NMieville/PA/hardware/dipole/C10/README.md

# KiCad JDC project template

Pour rendre ce template disponible dans KiCad, il faut copier ce repo dans `.../KiCad/[version]/template/`.

Il est ensuite disponible lorsqu'on sélection **New Project from Template...** puis **User Templates** dans KiCad.
