NMieville/PA/rapport/annexe.tex

\appendix

\section{Mesures capacitives RC}
\label{mesrc}
\begin{figure}[!ht]
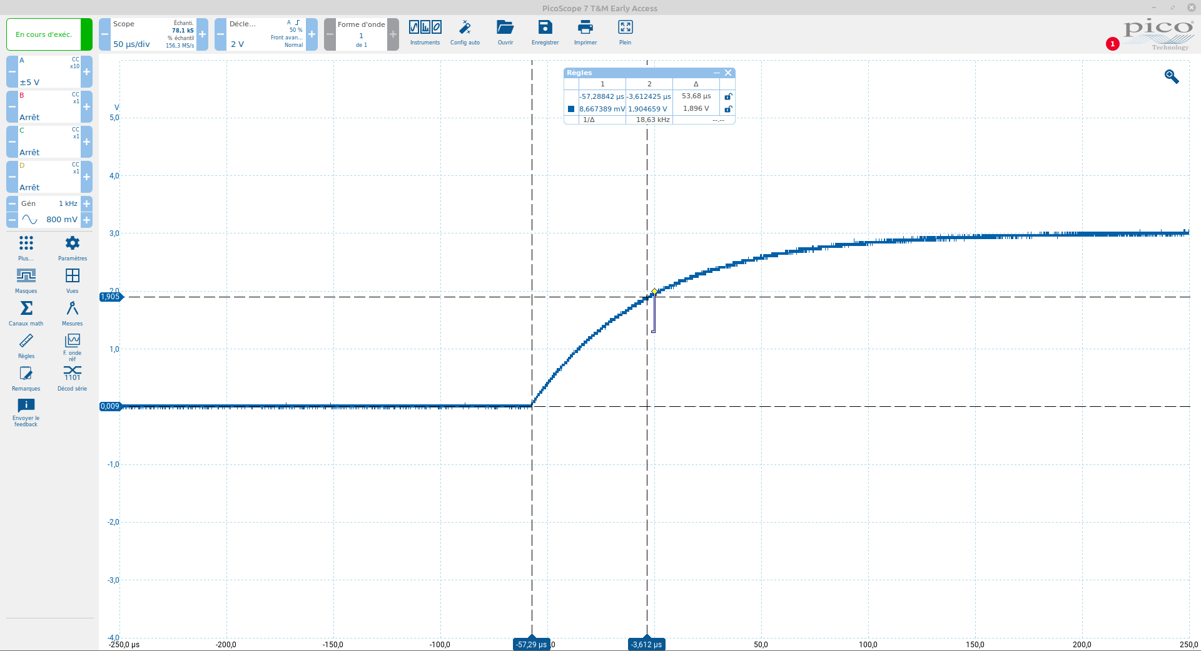
[picture p1: rapport/figuresMeasure/a.png]
  
  \caption{Oscillogramme de mesure RC du PCB A}
\end{figure}

\begin{figure}[!ht]
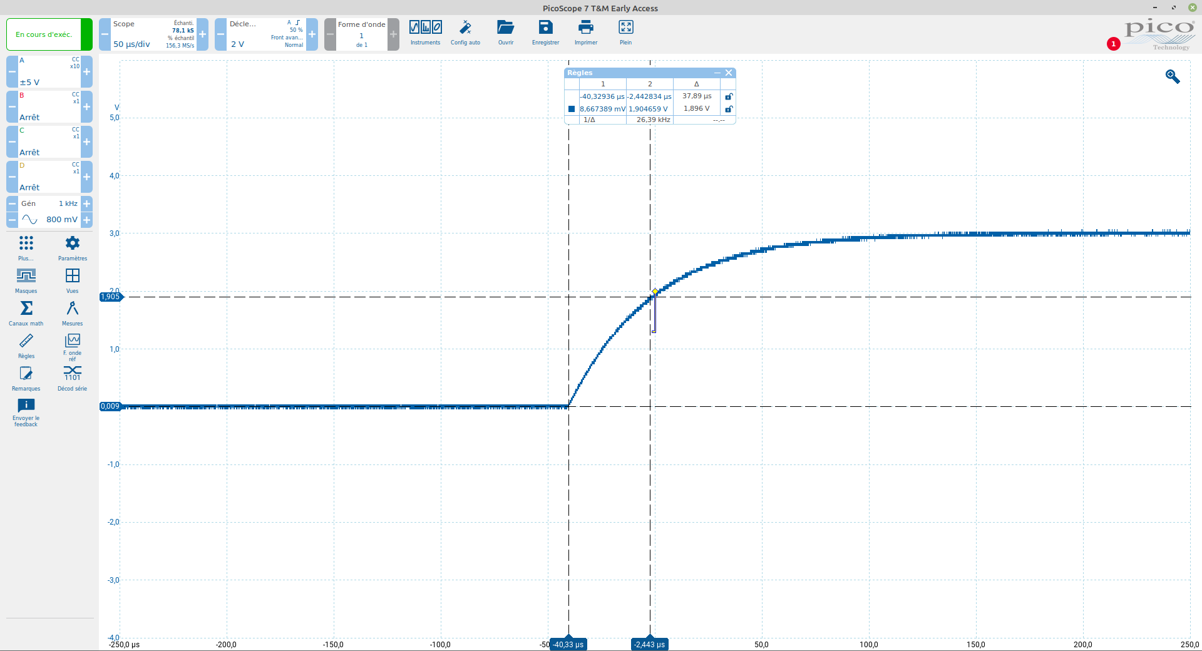
[picture p2: rapport/figuresMeasure/b.png]
  
  \caption{Oscillogramme de mesure RC du PCB B}
\end{figure}

\newpage

\begin{figure}[!ht]
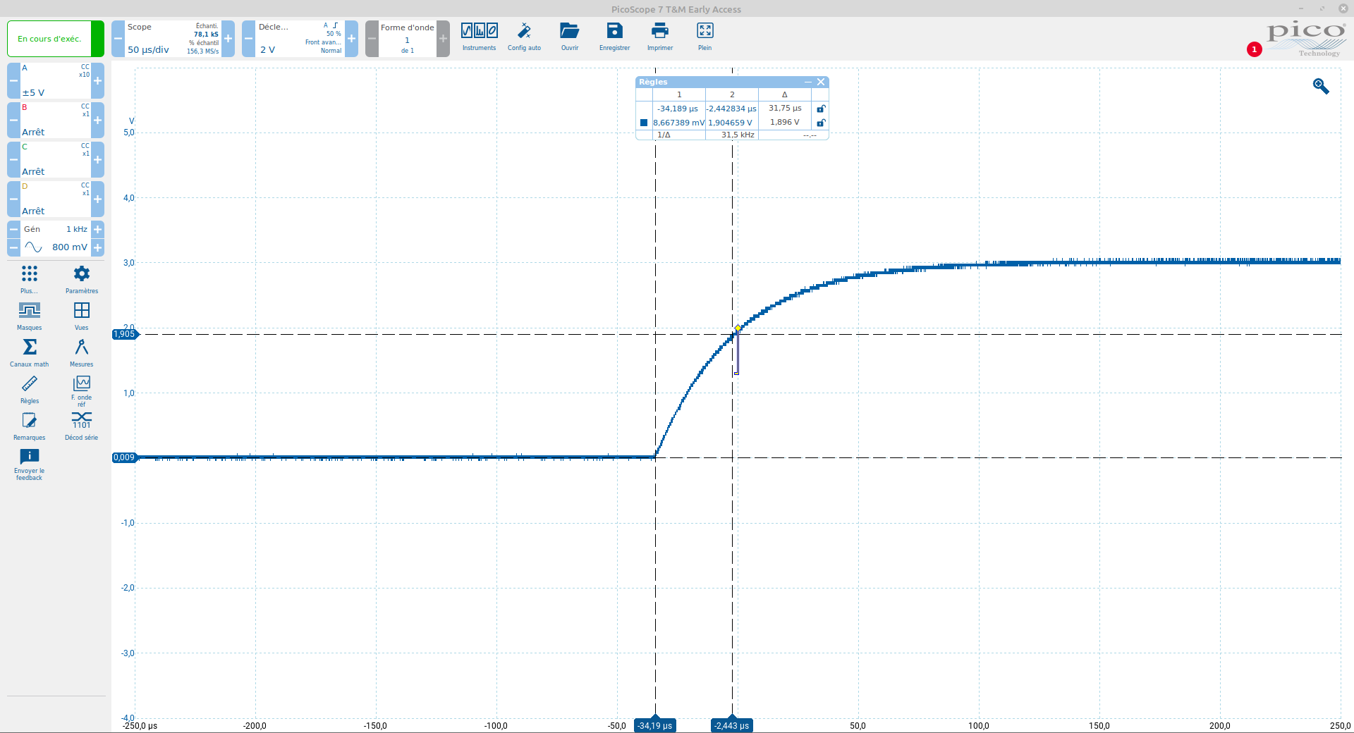
[picture p3: rapport/figuresMeasure/c.png]
  
  \caption{Oscillogramme de mesure RC du PCB C}
\end{figure}

\begin{figure}[!ht]
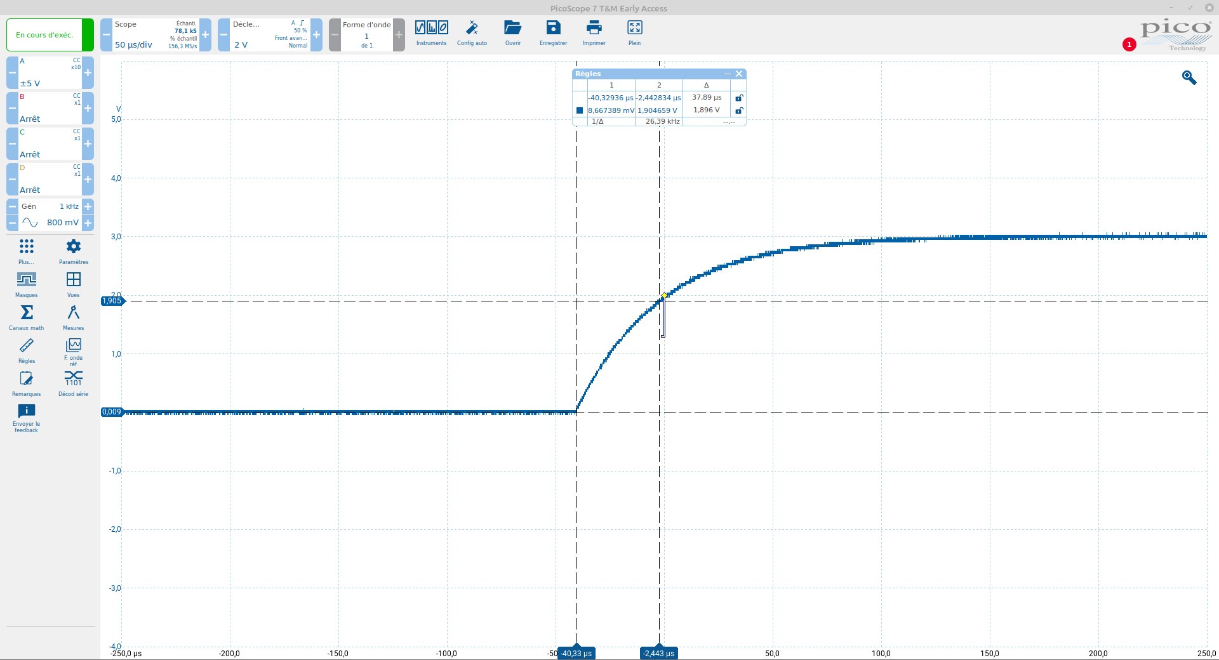
[picture p4: rapport/figuresMeasure/d.png]
  
  \caption{Oscillogramme de mesure RC du PCB D}
\end{figure}

\newpage

\begin{figure}[!ht]
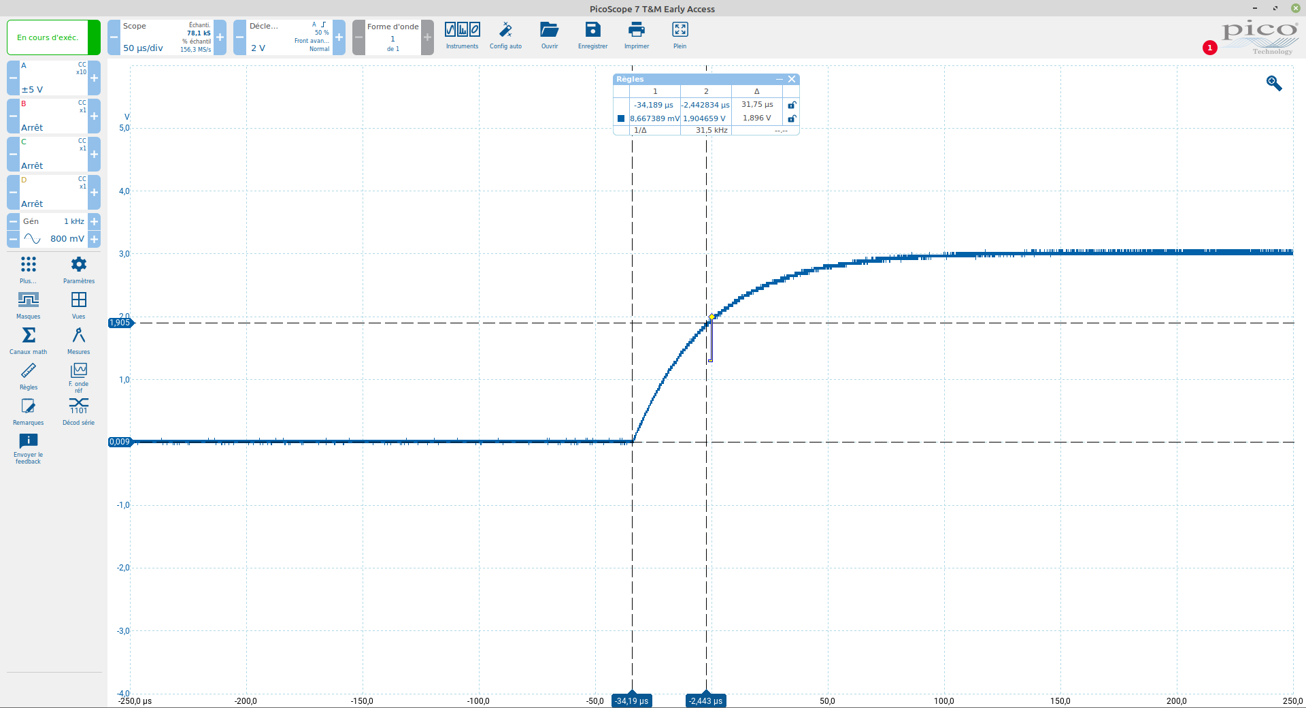
[picture p5: rapport/figuresMeasure/e.png]
  
  \caption{Oscillogramme de mesure RC du PCB E}
\end{figure}

\begin{figure}[!ht]
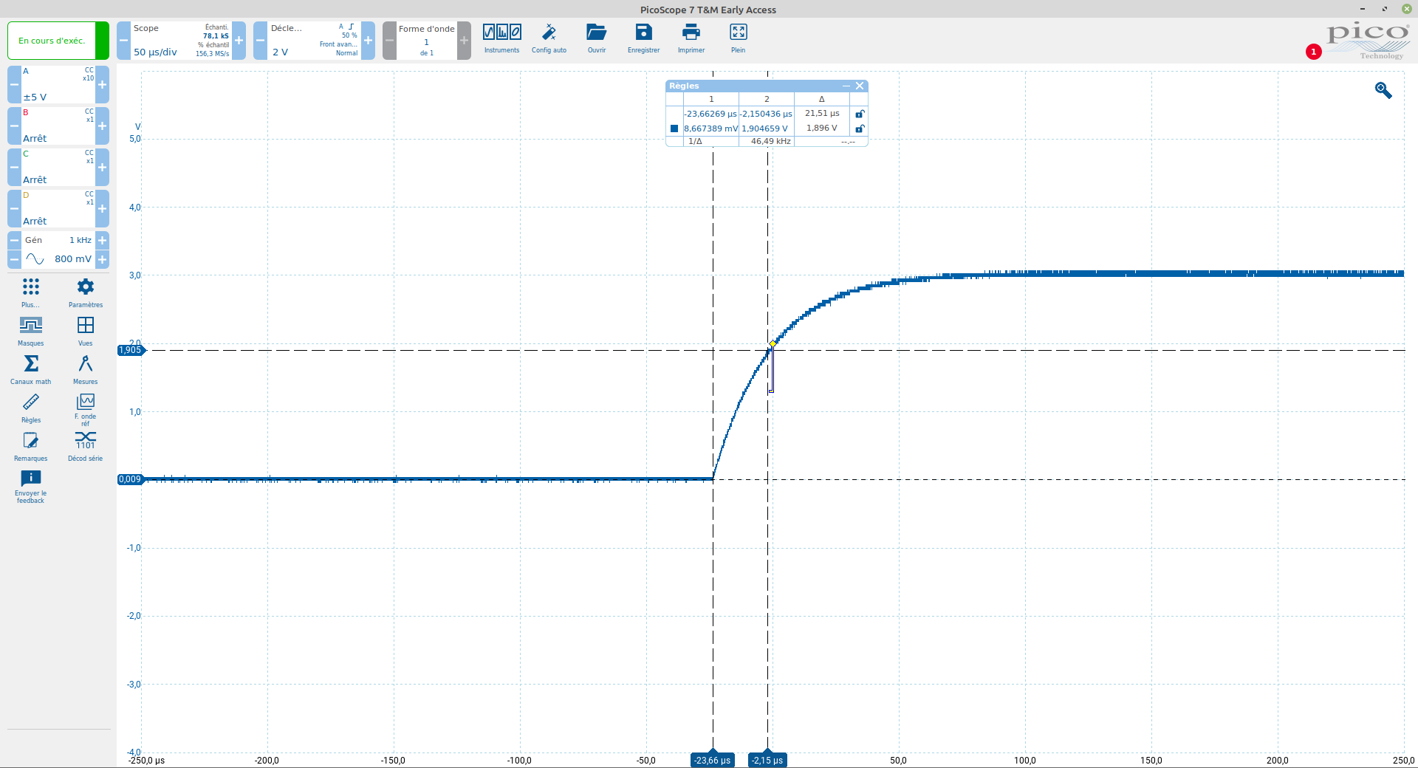
[picture p6: rapport/figuresMeasure/f.png]
  
  \caption{Oscillogramme de mesure RC du PCB F}
\end{figure}

\newpage

\section{Datasheet AD7150}
\label{dataad}

\includepdf[pages=-]{annexes/AD7150-1501845}
