NMieville/PA/rapport/pa-rapport.tex

\documentclass[a4paper, french, 10pt]{article} % Type du document

% compiler avec : pdflatex, bibtex, pdflatex, pdflatex

% +---------------------------------------------------------------+
% | Language
% +---------------------------------------------------------------+
\usepackage[T1]{fontenc}
\usepackage[utf8]{inputenc}
\usepackage[french]{babel}
\usepackage{graphicx}
\usepackage{multirow}
\usepackage{subfiles}
\usepackage{bytefield}
\usepackage{lastpage}
\usepackage{siunitx}
\usepackage[
backend=biber,
style=ieee,
sorting=none
]{biblatex}
\addbibresource{biblio.bib}

\usepackage[top=2.5cm, bottom=2.5cm, left=2.5cm, right=2.5cm, showframe=false]{geometry}
\usepackage{appendix}
\usepackage{pdfpages}

%% A PERSONNALISER %%%%%%%%%%%%%%%%%%%%%%%
\renewcommand{\author}{Nathan Miéville}
\newcommand{\prof}{Maurizio Tognolini }
\renewcommand{\title}{Leaf Wetness Sensor}
%%%%%%%%%%%%%%%%%%%%%%%%%%%%%%%%%%%%%%%%%%

\usepackage{fancyhdr}
\setlength{\headheight}{27.06pt}
\pagestyle{fancy}
% Header:
\renewcommand{\headrulewidth}{1pt}
\fancyhead[L]{\title} 
\fancyhead[R]{} 
% Footer:
\pagenumbering{arabic}
\fancyfoot{} % clear all footer fields
\renewcommand{\footrulewidth}{1pt}
\fancyfoot[R]{Page \thepage~/~\pageref{LastPage}} 
\fancyfoot[L]{\author }

\begin{document}

\include{title}

\newpage
\thispagestyle{empty}
\
\newpage
\thispagestyle{empty}
Accepté par la HES-SO Master (Suisse, Lausanne) sur proposition de\\[10pt]
Professeur \prof, conseiller du projet d'approfondissement\\[30pt]
Lausanne, le \today\\[40pt]

\begin{tabular}{lll}
\prof & \hspace{4cm} & Philippe Barrade\\
Conseiller du PA & \hspace{4cm} & Responsable de la filière Electrical Engineering\\
\end{tabular}

\newpage
\thispagestyle{empty}
\section*{Remerciements}
Je tiens à remercier JDC Electronic d'avoir accepté le projet et de m'avoir soutenu dans sa réalisation. Je remercie aussi le professeur \prof pour m'avoir suivi et conseillé durant ce travail.

\newpage
\thispagestyle{empty}
\tableofcontents

\newpage

\section{Introduction}
L'Agriculture doit évoluer pour faire face aux défis de notre époque. De nombreuses solutions sont en développement pour aider les agriculteurs à produire durablement, en respect avec la nature et en utilisant le moins de ressource possible tout en gardant une production suffisante pour atteindre la souveraineté alimentaire. L'agriculture de précision est une des solutions à toutes ces problématiques. L'objectif est d'utiliser la technologie pour produire mieux. En observant et en mesurant le plus de variable possible nous somme capable, grâce à des modèles, de prévoir les besoins d'une plantation et ainsi mieux optimiser la production en consommant moins de ressource tel que l'eau, les engrais ou les pesticides. 

Pour répondre à cette demande, JDC Electronic s'est lancé le défi de proposer une solution complète, facilement déployable par les agriculteurs. Nous voulons proposer un assortiment de capteur centralisé sur une seule plateforme. Cette plateforme embarquera plusieurs modèles pour différent aspect de la production. L'interface sera facilement lisible pour un agriculteur et donnera des indications claires en temps réel sur les moyens d’optimisations. Un projet innosuisse à été lancé en 2021 en collaboration avec Agroscope \cite{agro} et l'institut IICT de l'heig-vd. Il portait essentiellement sur la mesure et l'analyse du diamètre d'un fruit au cours de sa croissance en fonction de son arrosage. L'objectif est d'avoir un meilleur contrôle sur l'eau. Ce projet a permis le développement de l'écosystème des capteurs et de la plateforme et a abouti à des mesures en conditions réelles dans des plantations de professionnels. Les étapes suivantes sont l’agrandissement de la gamme de capteur, la mise en production puis la commercialisation.

\begin{figure}[!ht]
\centering
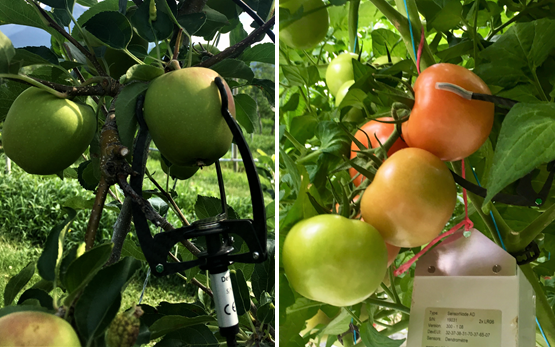
[picture p8: rapport/smart-dendro-apfel-tomate.png]
 
 \caption{Capteur de mesure du diamètre d'un fruit}
\end{figure}

Une des voies que JDC Electronic aimerait développer est la prévention des maladies agricoles. Les plantations sont les proies de nombreuses maladies qui peuvent être dévastatrices. Des modèles existent pour aider les agriculteurs à traiter au bon moment et éviter de devoir retraiter de nombreuses fois ou même de perdre leur production. L'un des modèle les plus utilisé \cite{doi:10.1094/PDIS-05-14-0529-FE}  se base sur la durée d'humectation. C'est-à-dire sur le temps que les gouttes créés par la rosée ou la pluie restent sur la feuille. Un capteur d'humectation permet d'obtenir cette grandeur.

L'objectif de ce travail sera d'effectuer une pré-étude afin de déterminer la faisabilité d'un tel capteur, de définir un cahier des charges et de fournir une preuve de concept. Nous commencerons par étudier ce qui se fait déjà avec un état de l'art. Les premières pistes nous permettrons d'effectuer une analyse fonctionnelle afin de définir clairement nos besoins et nos contraintes et ainsi être sûr de ne rien oublier. Le cahier des charges sera défini. Dans une partie conception nous mettrons en pratique ce que nous a appris notre analyse afin d'obtenir une vue concrète de notre capteur. Nous pourrons mettre en place une simulation afin de définir les dernières variables. Et enfin, nous effectuerons des mesures sur une collection de configuration choisi avec la simulation afin de présenter une preuve de concept.

\include{state-of-art}

\include{analysis}

\include{conception}

\include{simulation}

\include{measure}

\include{conclusion}

\section{Bibliographie}

\printbibliography

\include{annexe}

\end{document}
