NMieville/PA/rapport/pa_rapport.tex

\documentclass[a4paper,11pt,twoside,openright]{article} % Type du document

% compiler avec : pdflatex, bibtex, pdflatex, pdflatex

% +---------------------------------------------------------------+
% | Language
% +---------------------------------------------------------------+
\usepackage[T1]{fontenc}
\usepackage[utf8]{inputenc}
\usepackage[french]{babel}
\usepackage[margin=1.5cm]{geometry}
\usepackage{graphics}
\usepackage{multirow}
\usepackage{subfiles}

\newcommand{\nomAuteur}{Nathan Miéville}

\newcommand{\titre}{Rapport}

\newcommand{\prof}{Tognolini Maurizio}

\newcommand{\orientation}{Electrical Engineering (EIE) - Signal (courant faible)}

% +---------------------------------------------------------------+

\begin{document}

\title{Leaf Wetness sensor}

\maketitle

\newpage

\section{Introduction}
smartfarming, JDC, pluie, humidité, maladie

\section{Analyse fonctionnel}
\subsection{besoin}
Prévenir le dévlopement de maladie

Il existe des modèle empyrique qui se base sur le temps d'humidité sur la feuille. difficile a déterminer par les donné méto clasique (humidité température vents etc). Le recours à un capteur d'humectation est utile dans ce cas la.

\subsection{diagramme pieuvre}

\subsection{Cahier des charges}

\begin{table}[!h]
\begin{center}
\resizebox{\columnwidth}{!}{%
\begin{tabular}{|l|l|p{5cm}|l|}
\hline
 & \textbf{Fonctions} & \textbf{Critères} & \textbf{Niveaux}\\
\hline
\textbf{FP1} &Mesurer l'humectation des feuilles & Mesure d'humidité relative d'une surface & RH de 0\% à 100\%  résolution de 0.5\%  précision +- 0.25\%\\
\hline
\multirow{5}{*}{\textbf{FC1}} & S'intégrer dans l'environement Smart Farming JDC & Interface  de sortie I2C & Baud rate 100KHz. Adresse configurable\\\cline{3-4}
 &  & Structure de registre normalisé, & (voir doc JDC)\\\cline{3-4}
 &  & Démarrage de la mesure et acquisition après un temps. & 50ms pour la capture de la mesure\\\cline{3-4}
 &  & Connecteur JDC & Sortie 4 fil avec  VCC,GND,SDA,SCL\\\cline{3-4}
 &  & Alimentation normalisé & Tesion 3.3V\\\cline{3-4}
\hline
\textbf{FC2} & Consommer peu d'énergie & Courant maximum établit en fonctionnement & 1 mA\\
\hline
\textbf{FC3} & Eviter les faux positifs du à la métérologie & L'humidité de l'aire ne doit pas influencer la mesure & L'incidence de RH de l'aire < précision (0.25\%)\\
\hline
\textbf{FC4} & Résister aux milieux extérieur & Le capteur est protégé des intempéries et supporte une utilisation extérieur & Etanche IP44\\
\hline
\textbf{FC5} & S'intègrer dans les plantations & La taille du capteur ne doit pas gêner l'exploitation des plantations & Envergure maximum de 20cm\\
\hline
\textbf{FC6} & Etre facile d'installation & Le capteur doit pouvoir être installer par des agriculteurs sans formation technique & Système d'atache et un seul connecteur a brancher\\
\hline
\textbf{FC7} & Etre Certifié & Le capteur doit être certifié pour être proposé sur le marché & Certification EM,CE\\
\hline
\end{tabular}
}
\end{center}
\end{table}

\subsection{diagramme Fast}

\subsection{diagramme fonctionnel}

\section{Etat de l'art}
resistif:
plusieur constructeur:
Davis,Spectrum Caipos Lw
grille mesure electrique:
+ pas cher
- ne détecte pas les fine coute -> peinture
faux positif avec l'humidité

Metos: deux électrode et un tissus -> même problème

capacitif:

Meter (ancienement DECAGON) PHYTOS31 
un des seul du marché beaucoup de revendeur

une expérimentation de: Instrumentation, Sensor and Interfaces Group, Universitat Politècnica de Catalunya, BarcelonaTech, Spain

\section{Simulation}

commmence simple par une fourche. On comence par une taille de 200 par 100 et avec un circuit standard: piste en cuivre 18um  épaisseur 1.55um 

\end{document}
