NMieville/PA/rapport/title.tex

\thispagestyle{empty}

\begin{figure}[ht]
	\begin{minipage}[c]{.49\textwidth}
		
	\end{minipage}%
	\hfill
	\begin{minipage}[c]{.49\textwidth}
		\raggedleft
		
	\end{minipage}%
\end{figure}

\begin{raggedright}
\begin{small}
Master of Science HES-SO in Engineering\\
Av. de Provence 6\\
CH-1007 Lausanne\\
\end{small}
\end{raggedright}

\vfill

\begin{raggedleft}
\begin{huge}
\textbf{Master of Science HES-SO in Engineering}\\
Orientation : Electrical Engineering (EIE)\\
\end{huge}

\vfill

{\Huge \title}\\

\vfill

{\large Fait par}\\[10pt]
{\Huge \textbf{\author}}\\[20pt]
\large Sous la direction de\\
\prof\\
Dans l'Institut d'Automatisation Industrielle de la HEIG-VD
\vfill

\large Lausanne, HES-SO Master, 2022\\
\end{raggedleft}
