NMieville/PA/350.jpg

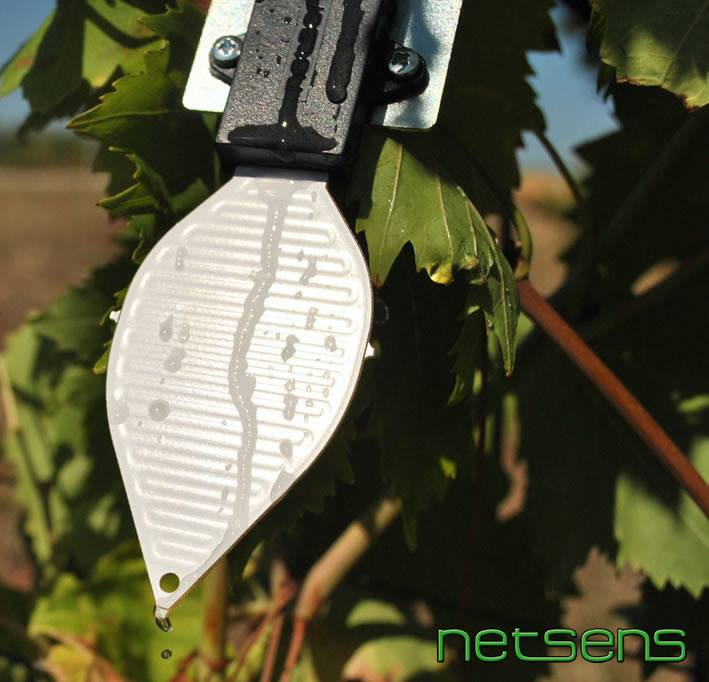
350.jpg
