NMieville/PA/284240028_571956854270425_316035304024272699_n.jpg

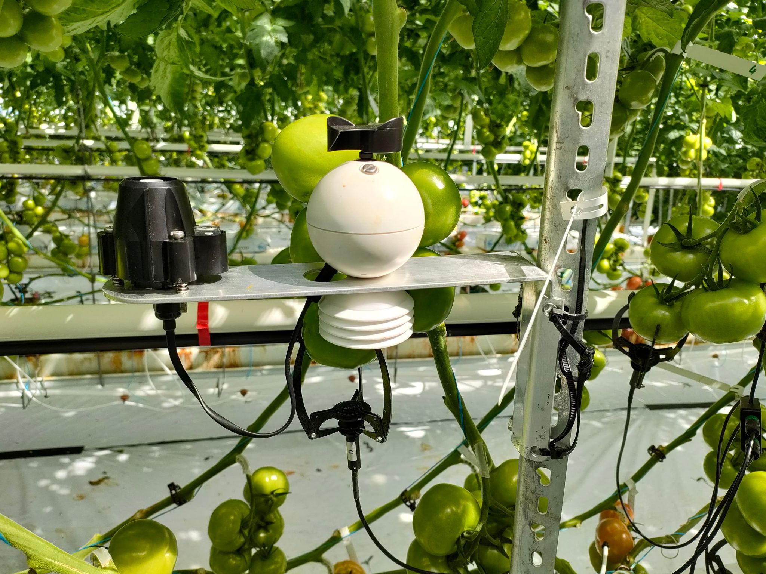
284240028_571956854270425_316035304024272699_n.jpg
