NMieville/PA/decomposition.png

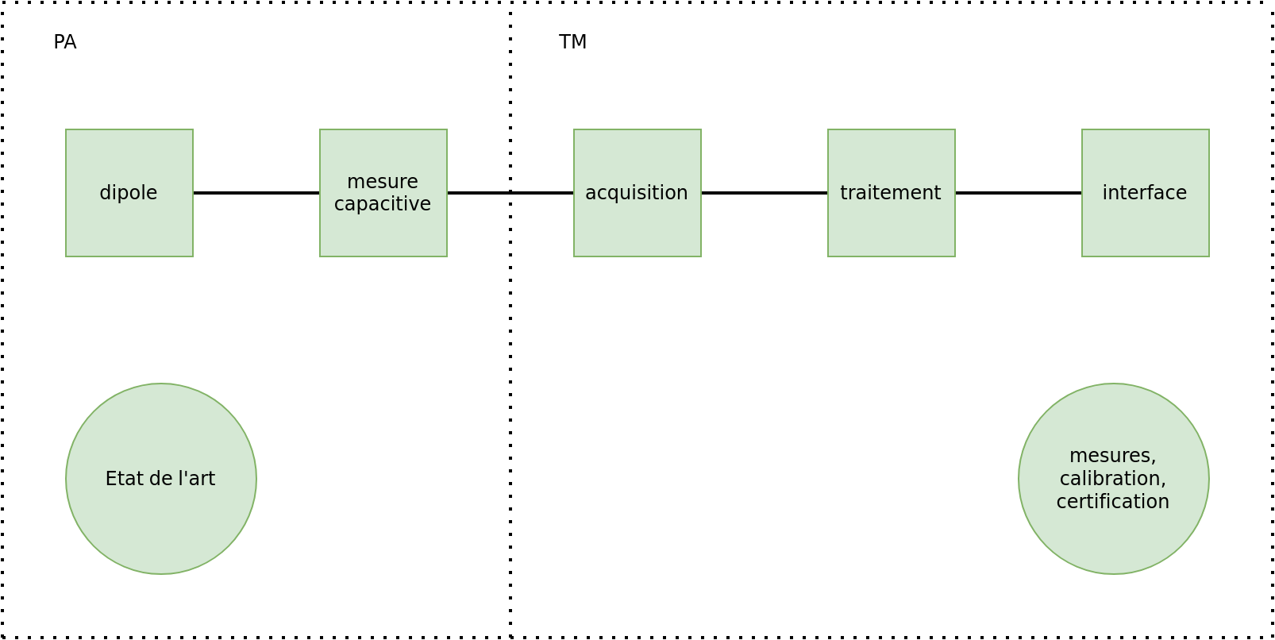
decomposition.png
