NMieville/PA/defense/ADPhoto.jpg

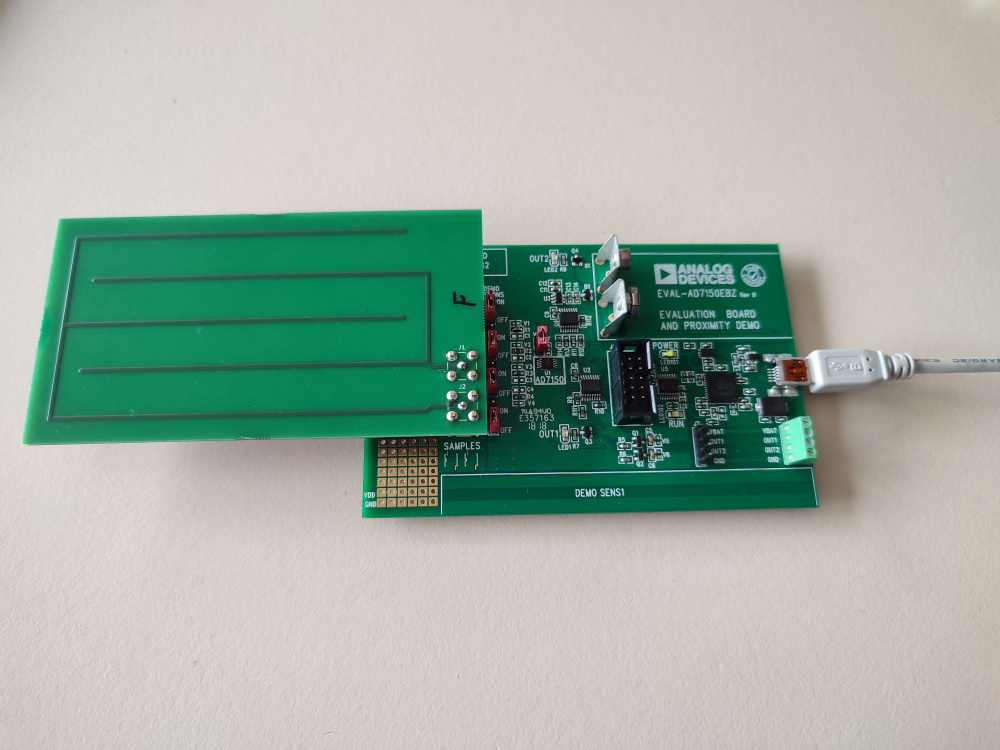
defense/ADPhoto.jpg
