NMieville/PA/defense/dipole-top.png

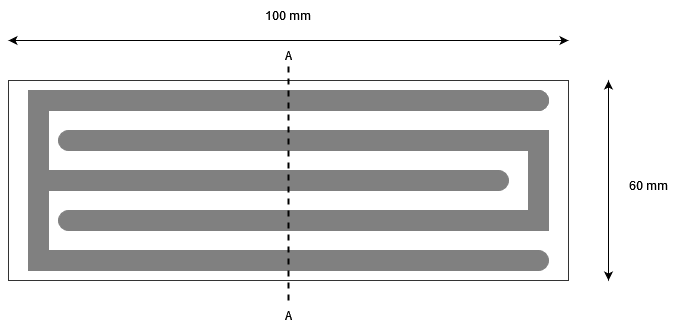
defense/dipole-top.png
