NMieville/PA/defense/hes.PNG

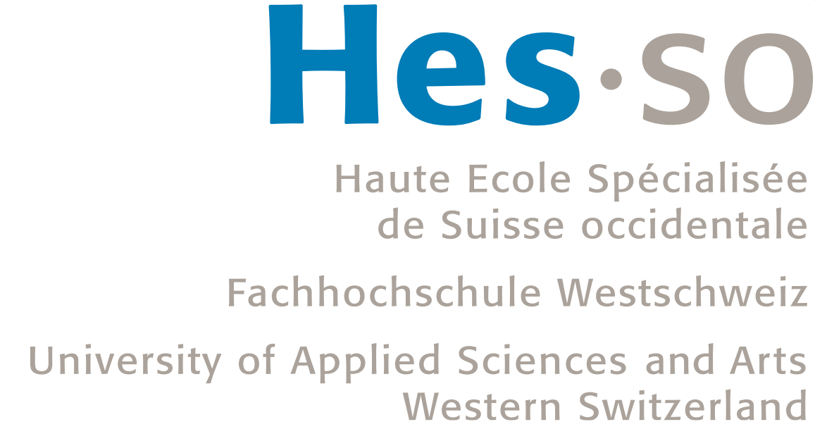
defense/hes.PNG
