NMieville/PA/defense/RCPhoto.jpg

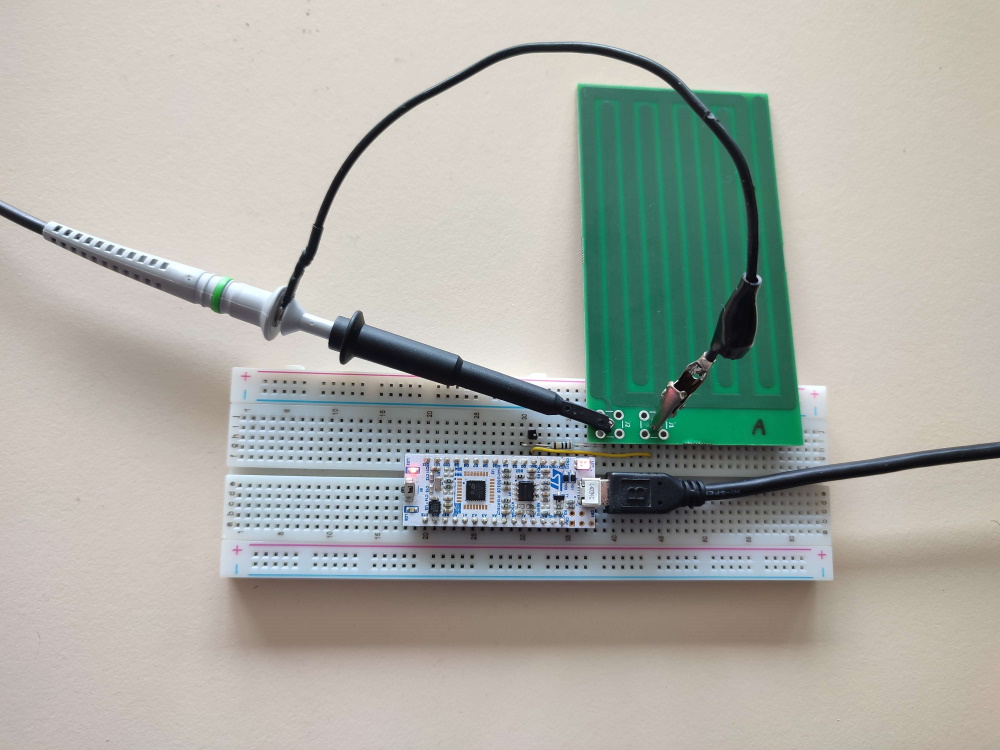
defense/RCPhoto.jpg
