NMieville/PA/defense/SchemaBlock.png

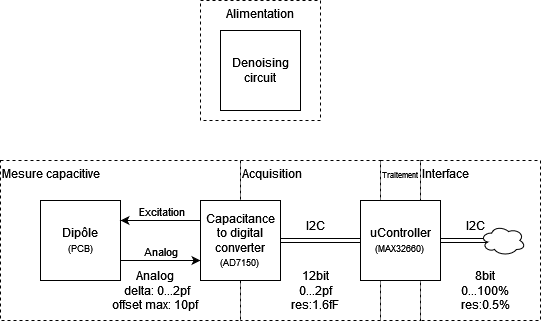
defense/SchemaBlock.png
