NMieville/PA/defense/schemaMesure-Page-1.png

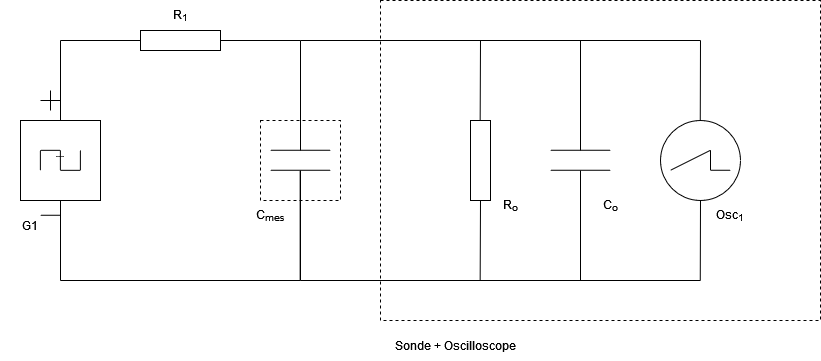
defense/schemaMesure-Page-1.png
