NMieville/PA/defense/table.PNG

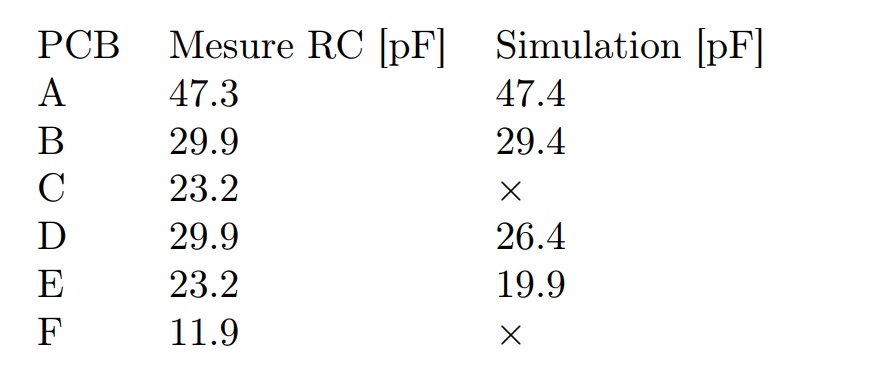
defense/table.PNG
