NMieville/PA/photo-fond.jpg

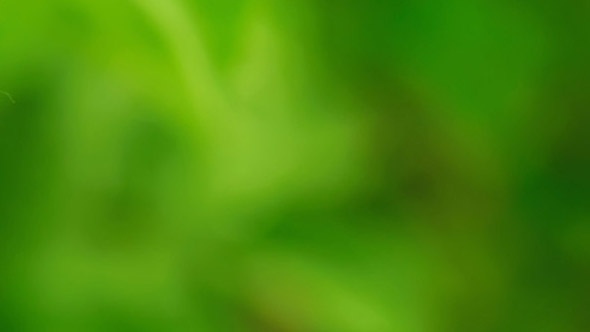
photo-fond.jpg
