NMieville/PA/photo-title.jpg

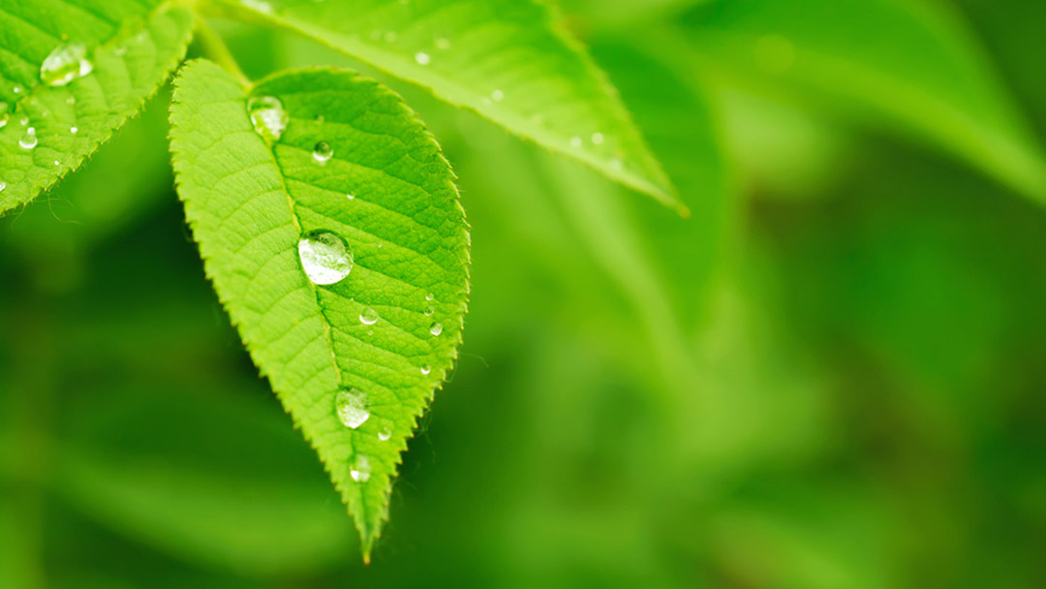
photo-title.jpg
