NMieville/PA/rapport/figuresSimulation/C20eauGraph.png

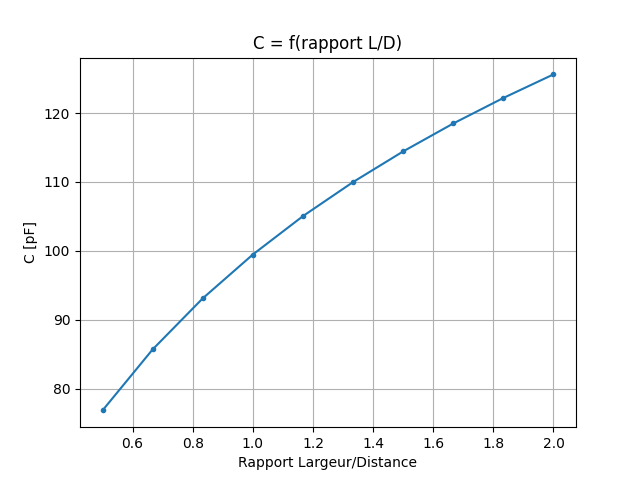
rapport/figuresSimulation/C20eauGraph.png
