NMieville/PA/rapport/figuresSimulation/C510masseGraph1.png

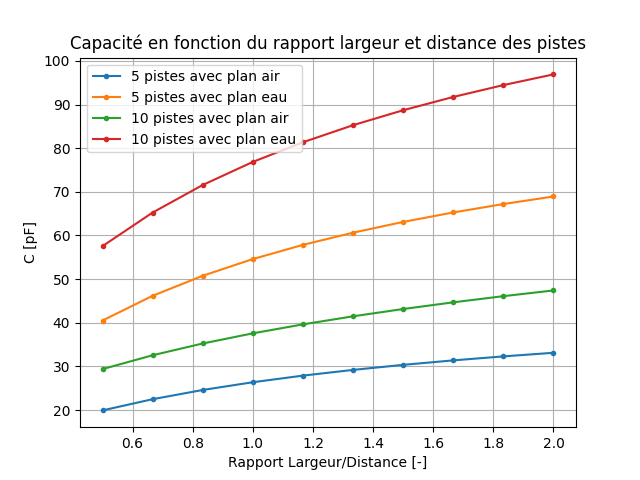
rapport/figuresSimulation/C510masseGraph1.png
