NMieville/PA/rapport/figuresSimulation/C510masseGraph2.png

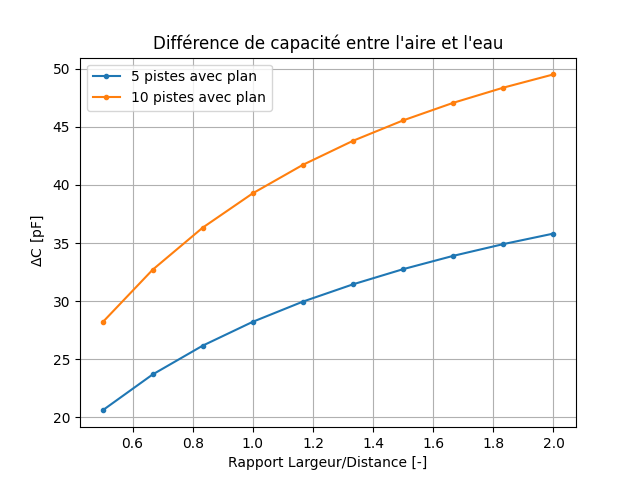
rapport/figuresSimulation/C510masseGraph2.png
