NMieville/PA/rapport/figuresSimulation/simulationChampElectriqueLarge.png

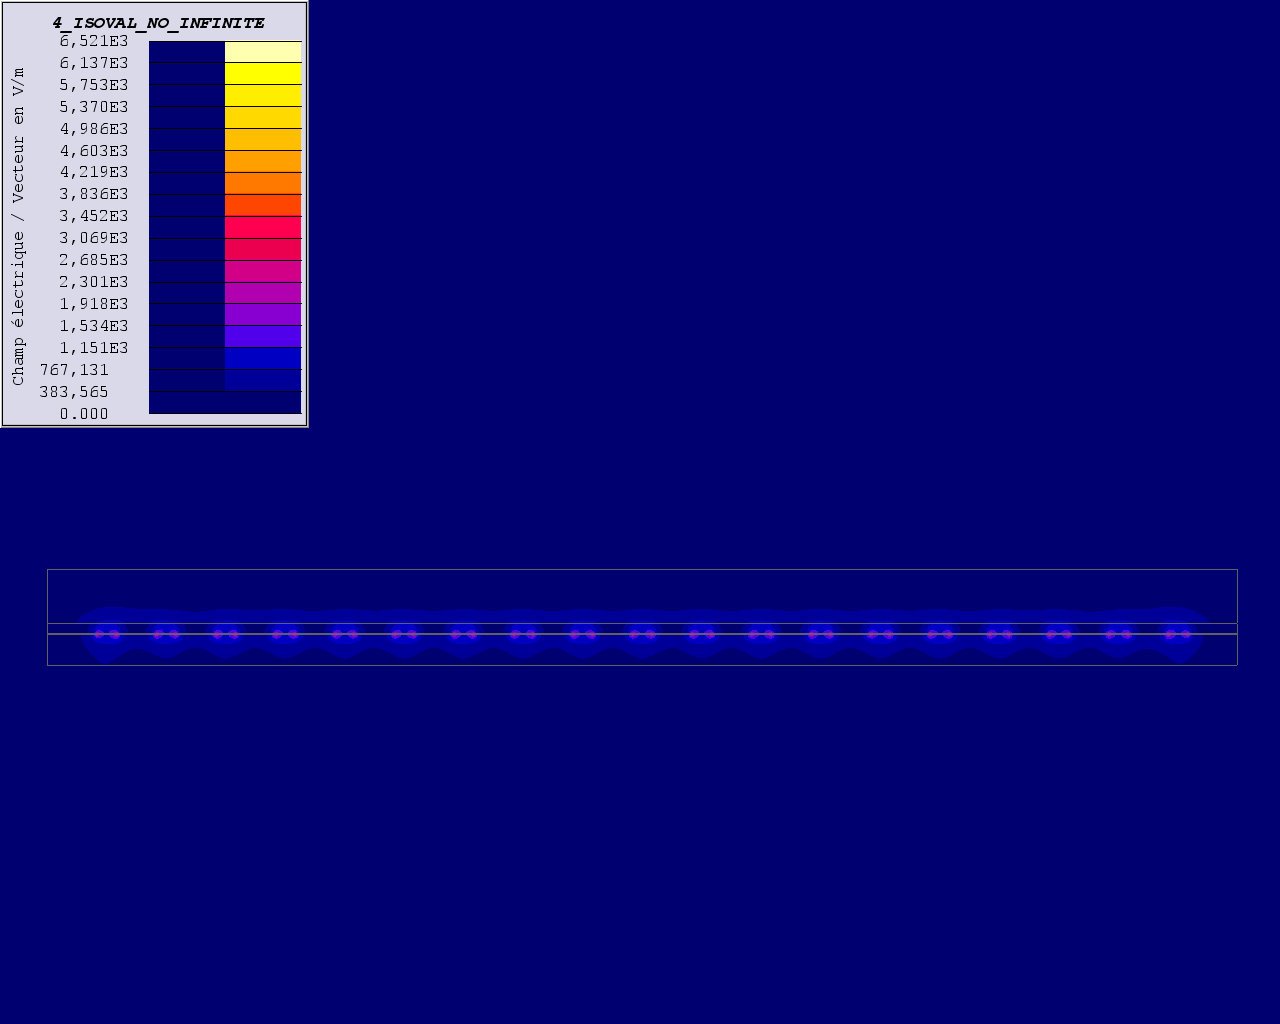
rapport/figuresSimulation/simulationChampElectriqueLarge.png
