NMieville/PA/rapport/figuresMeasure/Capture d’écran du 2023-05-23 16-46-55.png

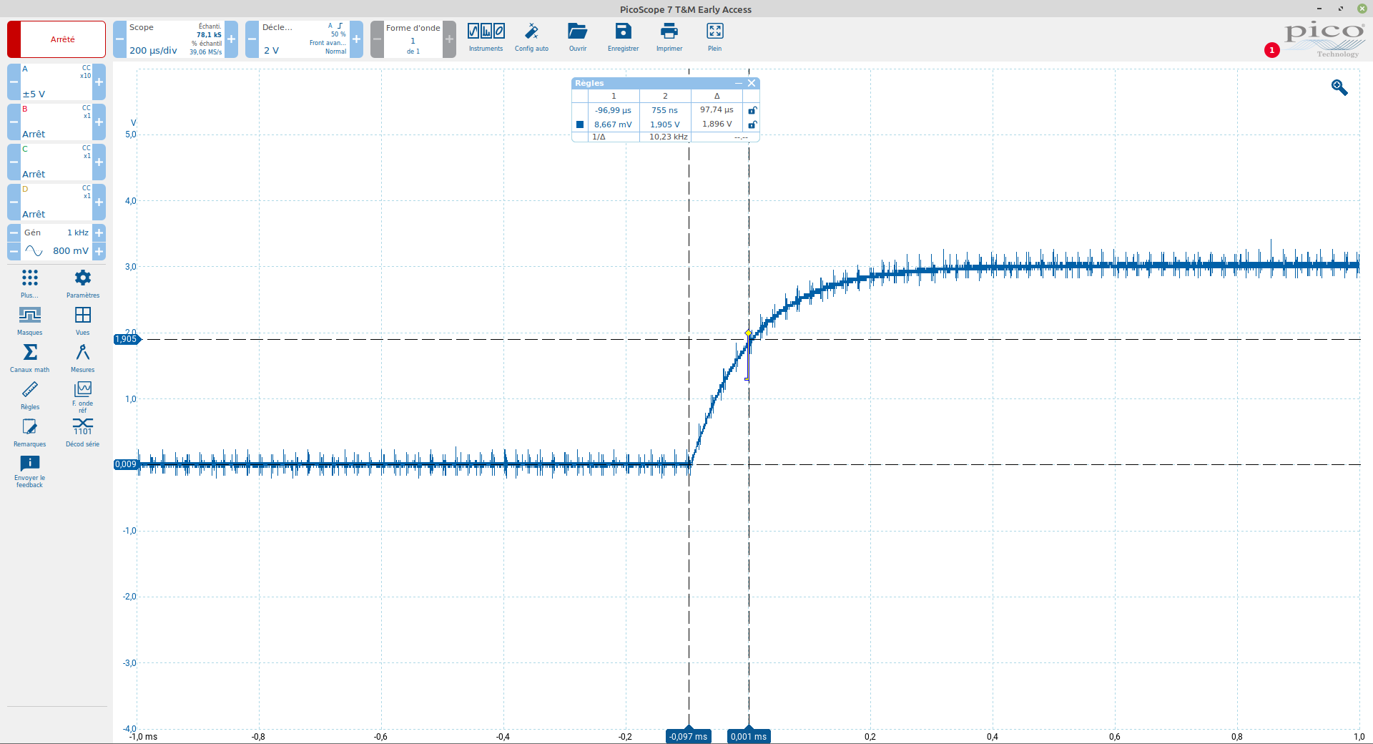
rapport/figuresMeasure/Capture d’écran du 2023-05-23 16-46-55.png
