NMieville/PA/rapport/figuresMeasure/Dcap.png

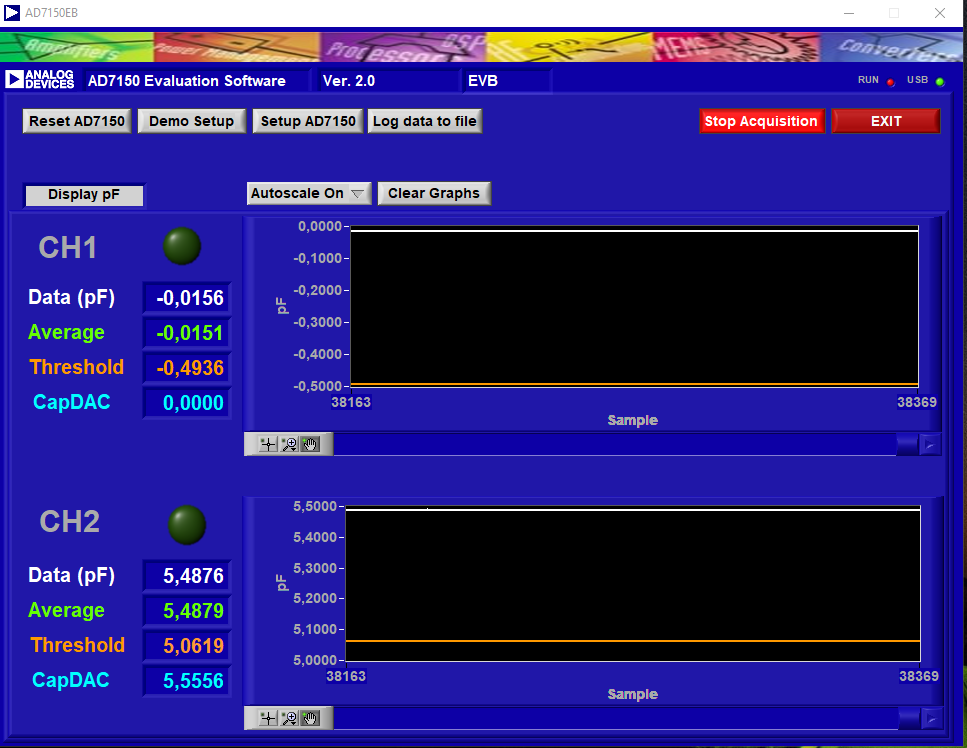
rapport/figuresMeasure/Dcap.png
