NMieville/PA/rapport/figuresMeasure/pulse.png

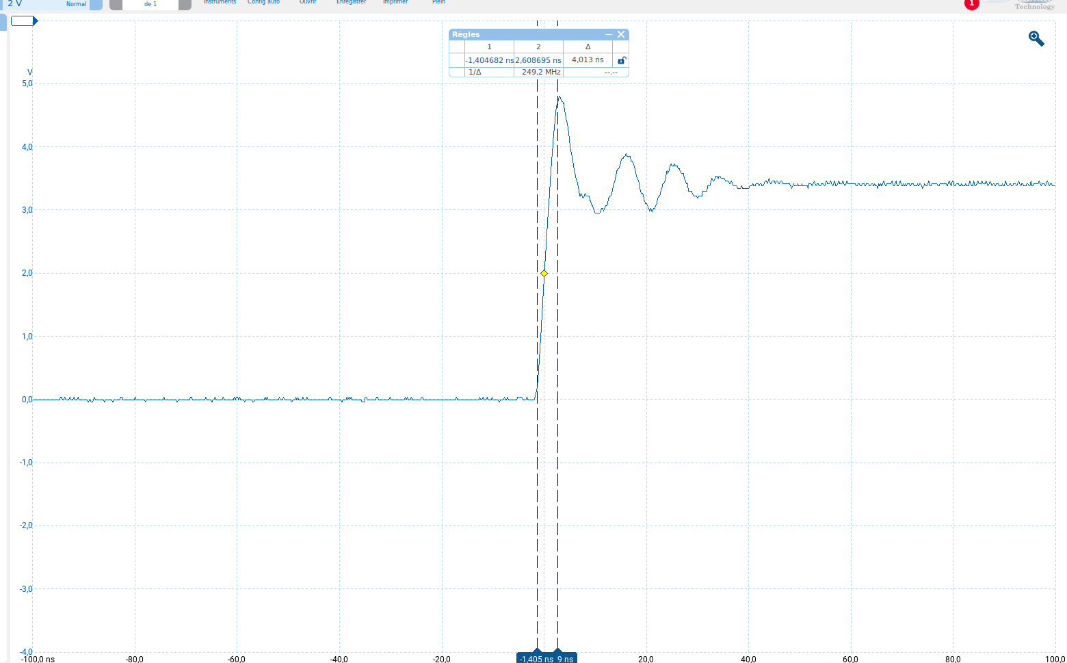
rapport/figuresMeasure/pulse.png
