NMieville/PA/rapport/figuresAnalysis/DiagrammeFAST.pdf

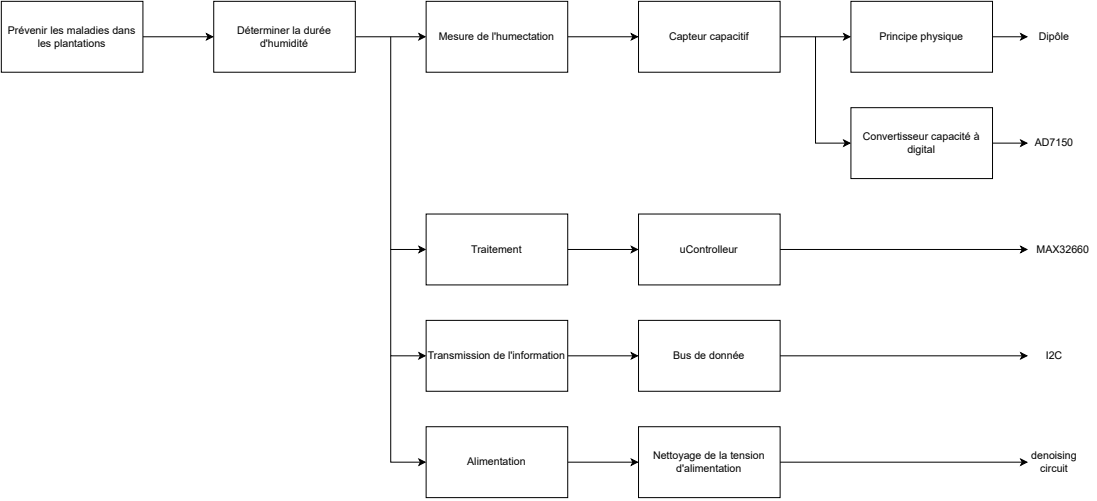
[picture p55: page 1]
d'humidité; Mesure de l'humectation; Traitement; Principe physique; uControlleur; Dipôle; Capteur capacitif; Convertisseur capacité à digital; MAX32660; Alimentation; Nettoyage de la tension; d'alimentation; denoising circuit

Prévenir les maladies dans
les plantations

Déterminer la durée

Transmission de l'information

Bus de donnée
