NMieville/PA/rapport/figuresAnalysis/SchemaBlock.pdf

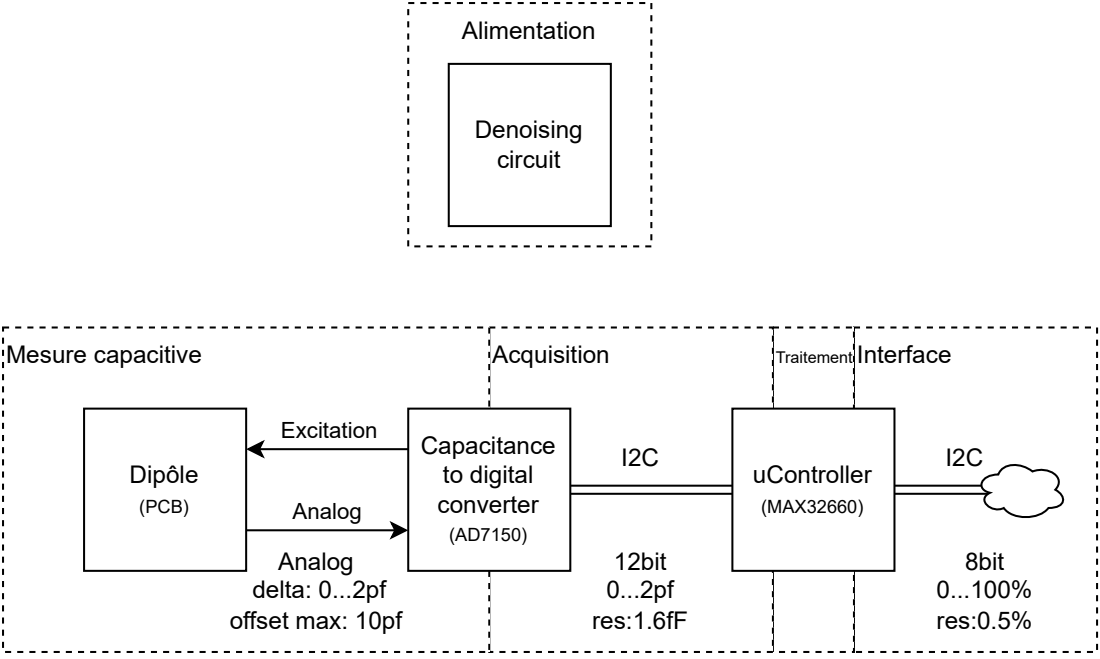
[picture p56: page 1]
Mesure capacitive; Acquisition; Traitement Interface; Dipôle; (PCB); Excitation; Capacitance; to digital converter; uController; Analog; (MAX32660); 12bit 0...2pf res:1.6fF; 8bit 0...100% res:0.5%; Analog delta: 0...2pf offset max: 10pf; Alimentation; Denoising circuit
