NMieville/PA/rapport/figuresAnalysis/DiagrammeCorne.drawio.pdf

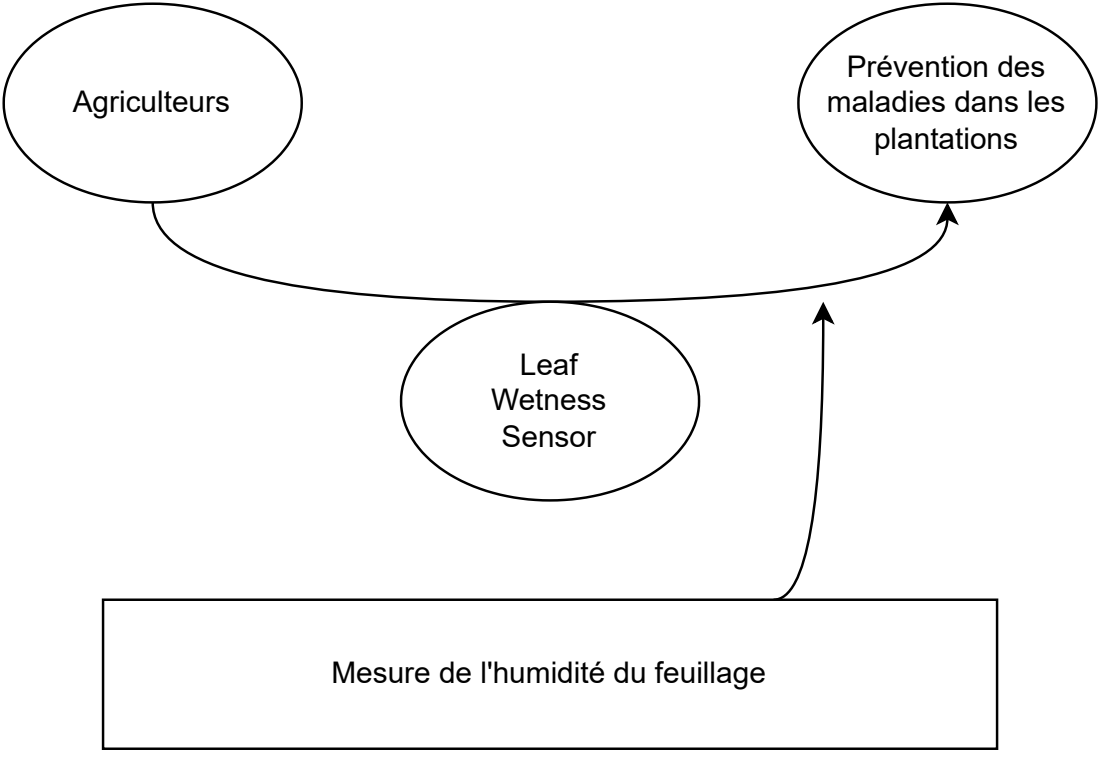
[picture p57: page 1]
Agriculteurs; Leaf Wetness Sensor

Prévention des
maladies dans les
plantations

Mesure de l'humidité du feuillage
