NMieville/PA/rapport/figuresMeasure/schemaMesure.pdf

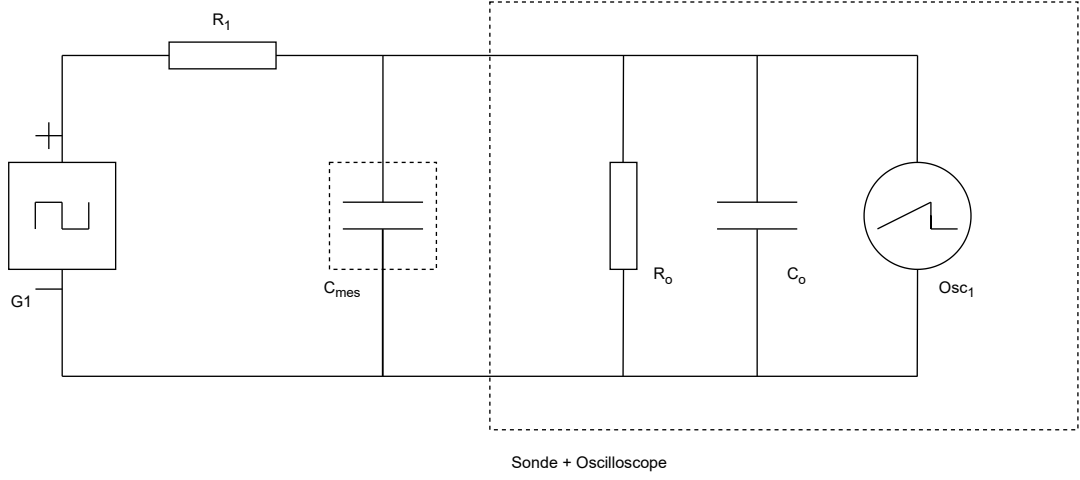
[picture p58: page 1]
Sonde + Oscilloscope; Cmes; Osc1
