NMieville/PA/rapport/figuresMeasure/schemaMesureTh.pdf

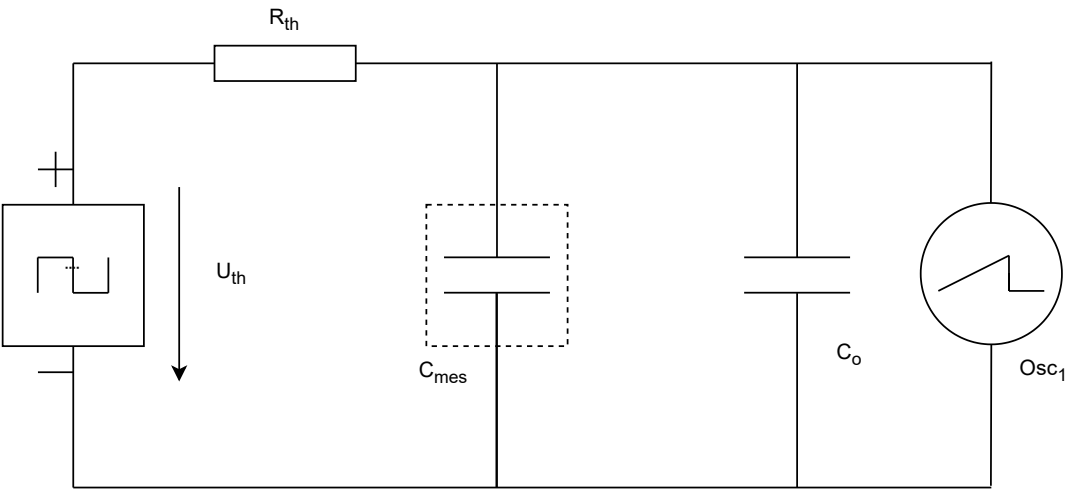
[picture p59: page 1]
Cmes; Rth; Uth; Osc
