NMieville/PA/rapport/figuresAnalysis/DiagrammePieuvre.drawio.pdf

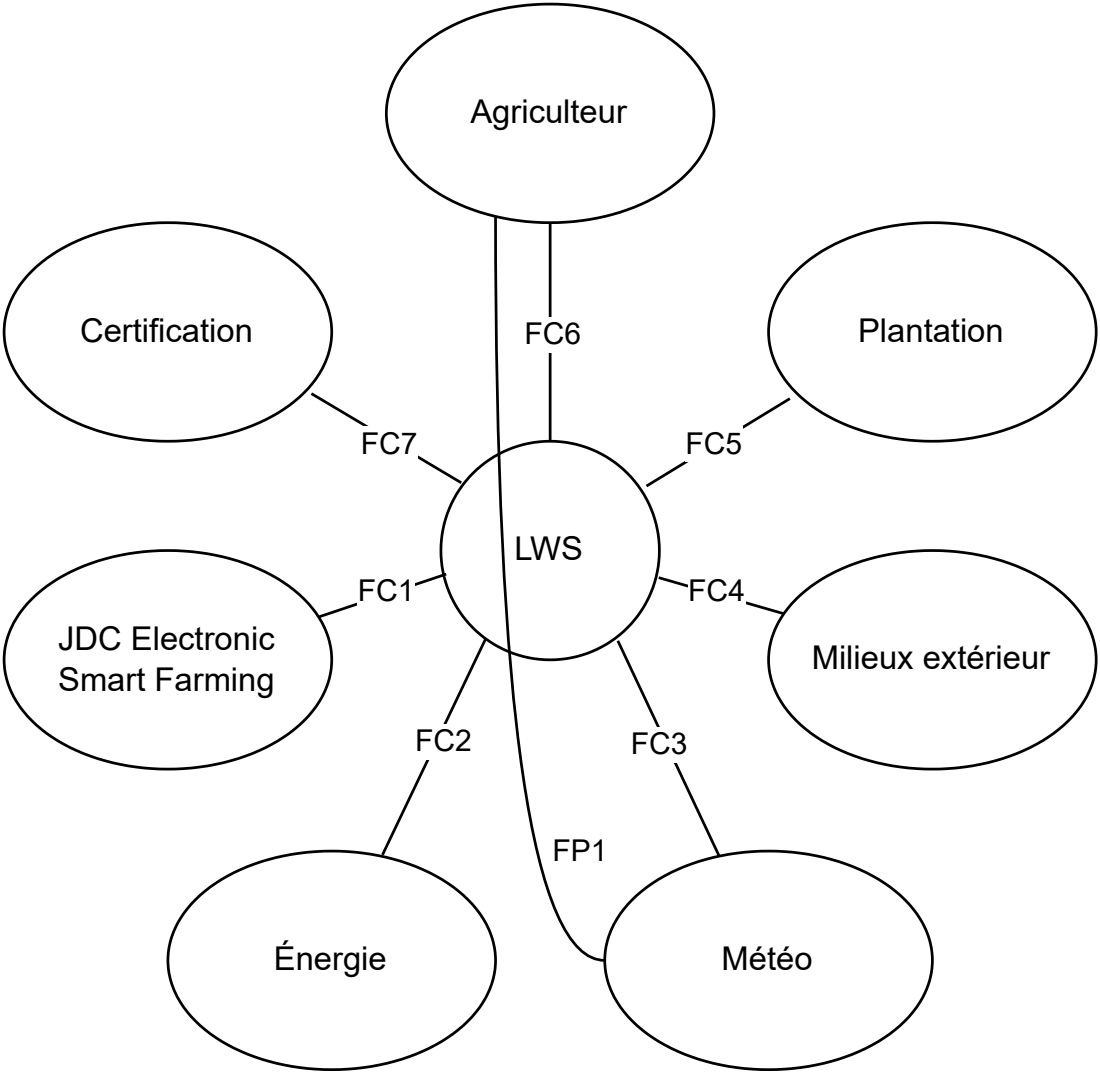
[picture p60: page 1]
Agriculteur; LWS; Plantation; Milieux extérieur; Météo; JDC Electronic Smart Farming; Certification; Énergie
