NMieville/PA/rapport/figuresConception/dipole-top.pdf

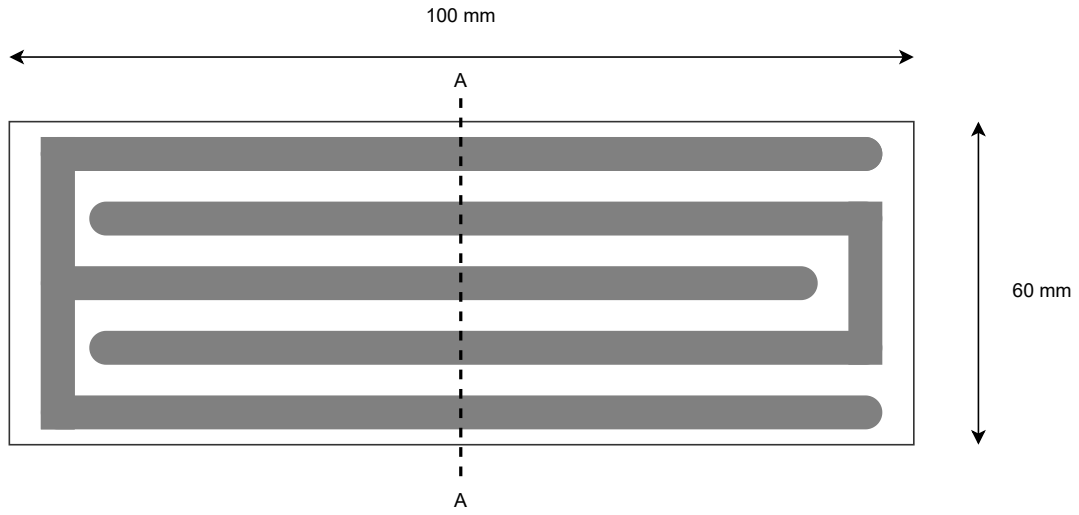
[picture p61: page 1]
