NMieville/PA/hardware/measure/leaf-wetness-sensor.kicad_sch

## KiCad design hardware/measure/leaf-wetness-sensor.kicad_sch (2023-04-05)

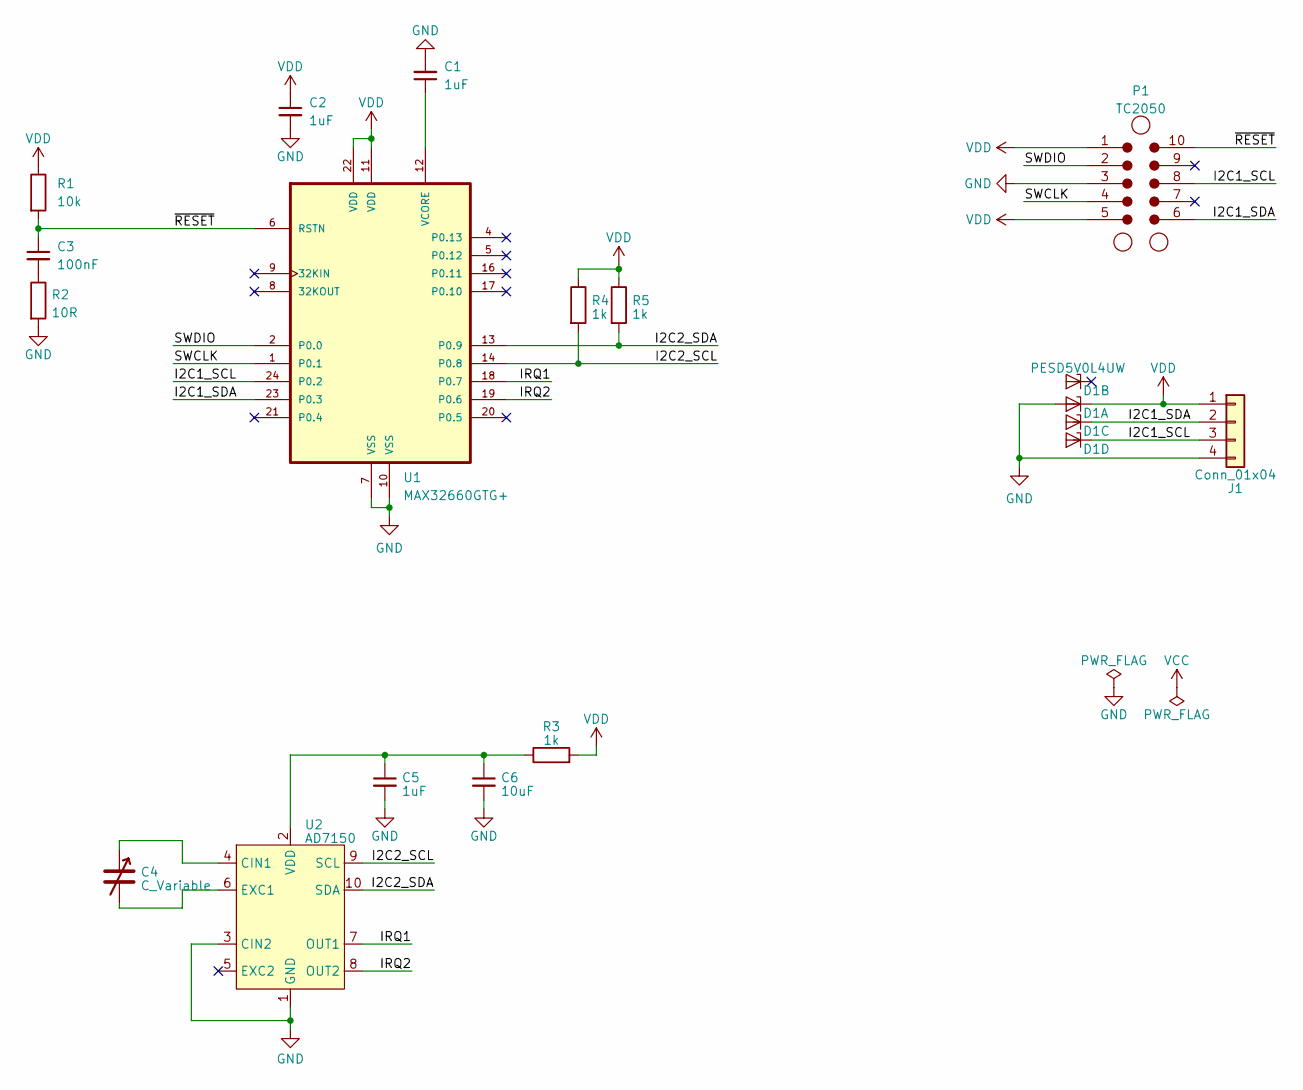
[picture p62: schematic leaf-wetness-sensor.kicad_sch]

Parts:
C1, C2: 1uF; C_0402_1005Metric
C3: 100nF; C_0402_1005Metric
C4: C_Variable
C5: 1uF
C6: 10uF
D1: PESD5V0L4UW; SOT-665; Mfr. Part No. PESD5V0L4UW,115
J1: Conn_01x04
P1: TC2050; Tag-Connect_TC2050-IDC-NL_2x05_P1.27mm_Vertical_with_bottom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
R1: 10k; R_0402_1005Metric; Mouser Part. No. 667-ERJ-2RKF1002X
R2: 10R; R_0402_1005Metric; Mouser Part. No. 667-ERJ-2RKF10R0X
R3, R4, R5: 1k
U1: MAX32660GTG+; TQFN-24-1EP_3x3mm_P0.4mm_EP1.7x1.7mm; Mouser Part. No. 700-MAX32660GTG+T
U2: AD7150

Connections:
GND: C1.2, C2.2, C5.2, C6.2, D1.2 (A), J1.4, P1.3, R2.2, U1.7 (VSS), U1.10 (VSS), U2.1 (GND), U2.3 (CIN2)
I2C1_SCL: D1.5 (K4), J1.3, P1.8, U1.24 (P0.2)
I2C1_SDA: D1.4 (K3), J1.2, P1.6, U1.23 (P0.3)
I2C2_SCL: R4.2, U1.14 (P0.8), U2.9 (SCL)
I2C2_SDA: R5.2, U1.13 (P0.9), U2.10 (SDA)
IRQ1: U1.18 (P0.7), U2.7 (OUT1)
IRQ2: U1.19 (P0.6), U2.8 (OUT2)
unnamed: C1.1, U1.12 (VCORE)
unnamed: C3.2, R2.1
unnamed: C4.1, U2.4 (CIN1)
unnamed: C4.2, U2.6 (EXC1)
unnamed: C5.1, C6.1, R3.1, U2.2 (VDD)
SWCLK: P1.4, U1.1 (P0.1)
SWDIO: P1.2, U1.2 (P0.0)
VDD: C2.1, D1.1 (K1), J1.1, P1.1, P1.5, R1.1, R3.2, R4.1, R5.1, U1.11 (VDD), U1.22 (VDD)
~RESET: C3.1, P1.10, R1.2, U1.6 (RSTN)
