NMieville/PA/hardware/dipole/C10/C10.kicad_sch

## KiCad design hardware/dipole/C10/C10.kicad_sch (2023-05-10)

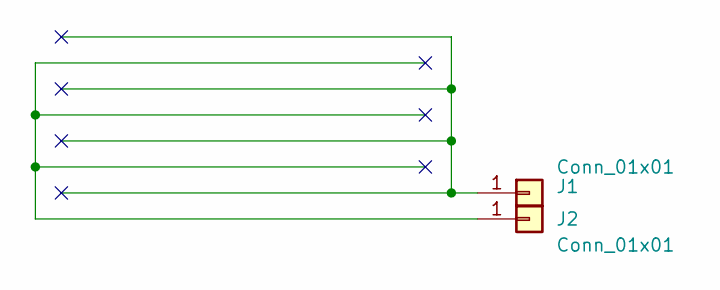
[picture p63: schematic C10.kicad_sch]

Parts:
J1, J2: Conn_01x01; SMB_Jack_Vertical
