NMieville/PA/(commit log)

2023-03-08 etat de l art
2023-04-05 add shematic
    [leaf-wetness-sensor.kicad_pcb, leaf-wetness-sensor.kicad_sch]
2023-05-10 add simulation data
    [C10air.xls, C10eau.xls, C20air.xls, C20eau.xls, C5air.xls, C5airMasse.xls, C5airMasseNoRes.xls, C5airMasseNoResPetit.xls]
2023-05-10 add proto sensor
    [C5.kicad_pcb, C5.kicad_sch, leaf-wetness-sensor.kicad_pcb, leaf-wetness-sensor.kicad_sch]
2023-05-21 add analysis conception and simulation part of the rapport
    [C10.kicad_pcb, C10.kicad_sch, C20.kicad_pcb, C20.kicad_sch, C5airMasseNoRes.xls, C5airMasseNoResPetit.xls, panel.kicad_pcb, panel.kicad_sch]
